Steficz/Regulace-topeni-HA/(commit log)

2026-11-10 design v0.4: centrala RPi3+GPIO+relay, boxy ESP32-C6(SHT40+SCD40), ESPHome fw, HA automations/lovelace, 3D scad + navody
    [centrala-mount-plate.scad, sensor-box.scad, valve-box.scad]
2026-11-10 relay: low-trigger schema (VCC z 3V3, GND izolace, inverted), 2x 8CH Smart Electronics, actor regenerated
    [gen-central.py]
2026-11-10 HW inventarizace: 3x 8CH TONGLING boardy (24 kanalu) prebrany, bench zapojeni oznaceno k prepnuti, BOM bez nakupu relatu
2026-11-10 residue: diagram+BOM sjednoceny na 3x 8CH
2026-11-10 wireframy dashboardu 1-3 html (preview/detail/sprava), fix grid zanozeni
2026-11-11 review fixes: preparene min ON/OFF vetveni, mrazovka prestojuje zadrze, boot seed t_change, strtof setpoint, heartbeat 30s, esp-idf framework C6, friendly_name prefixy entit (box+akter), var B nepouz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
    [box.yaml]
2026-11-11 akter: friendly_name Vyt Central -> entity prefix switch.vyt_central_jX_ventil (osazeni drivejsiho sed no-op)
